Dee-24r/sprint/image.png

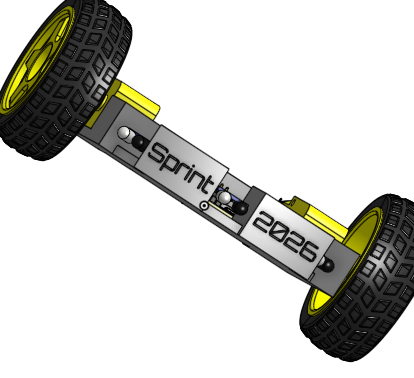
image.png
