Dee-24r/sprint/images/SCH_Sprint-Remote.png

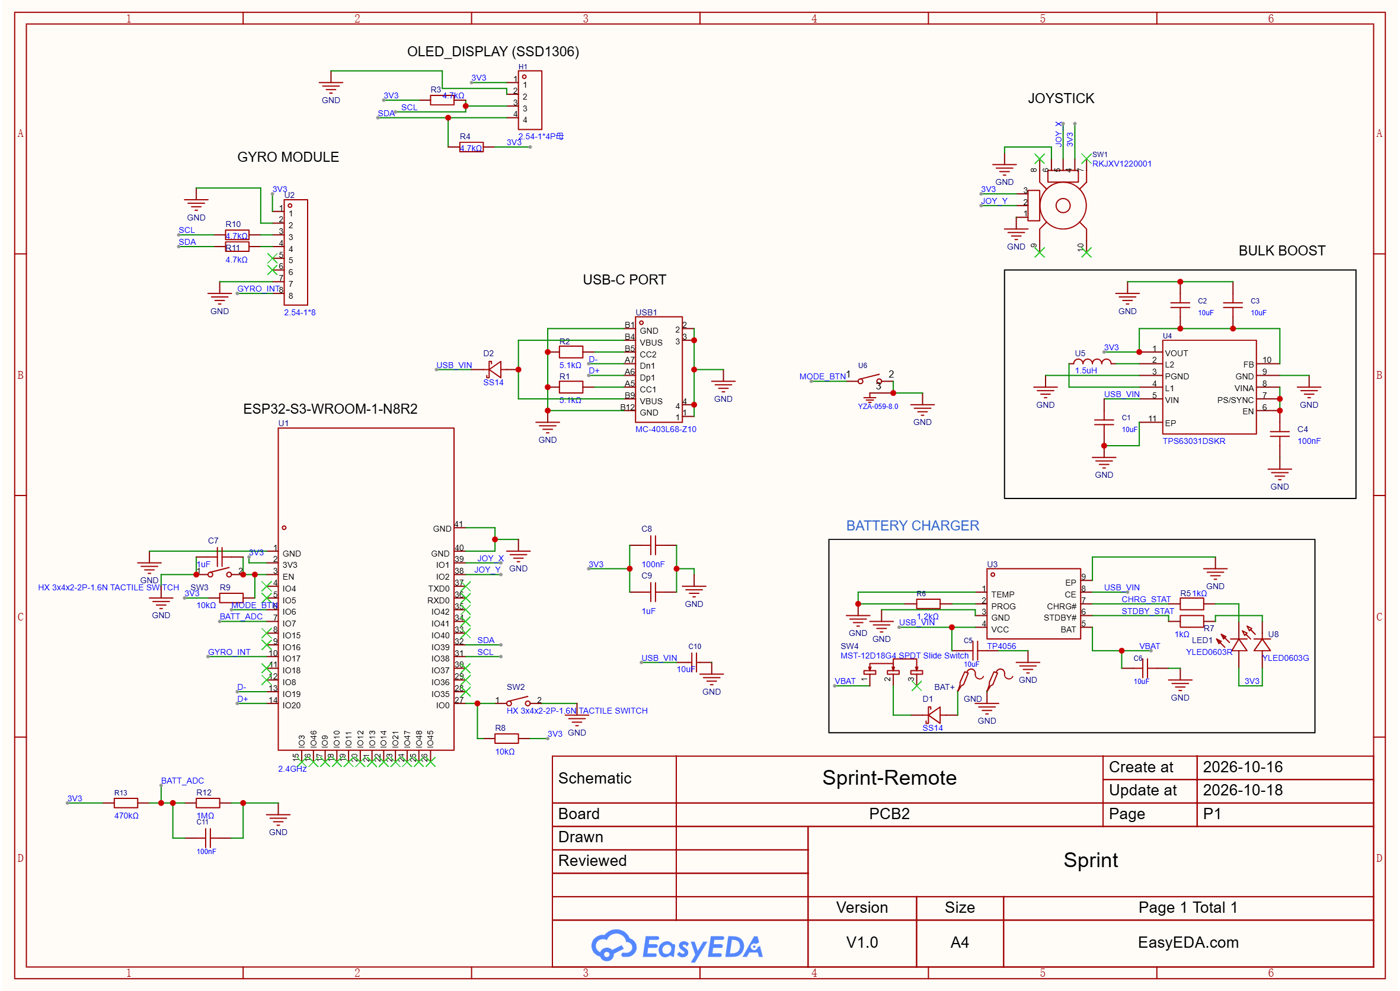
images/SCH_Sprint-Remote.png
