Dee-24r/sprint/images/Sprint-Mainboard.png

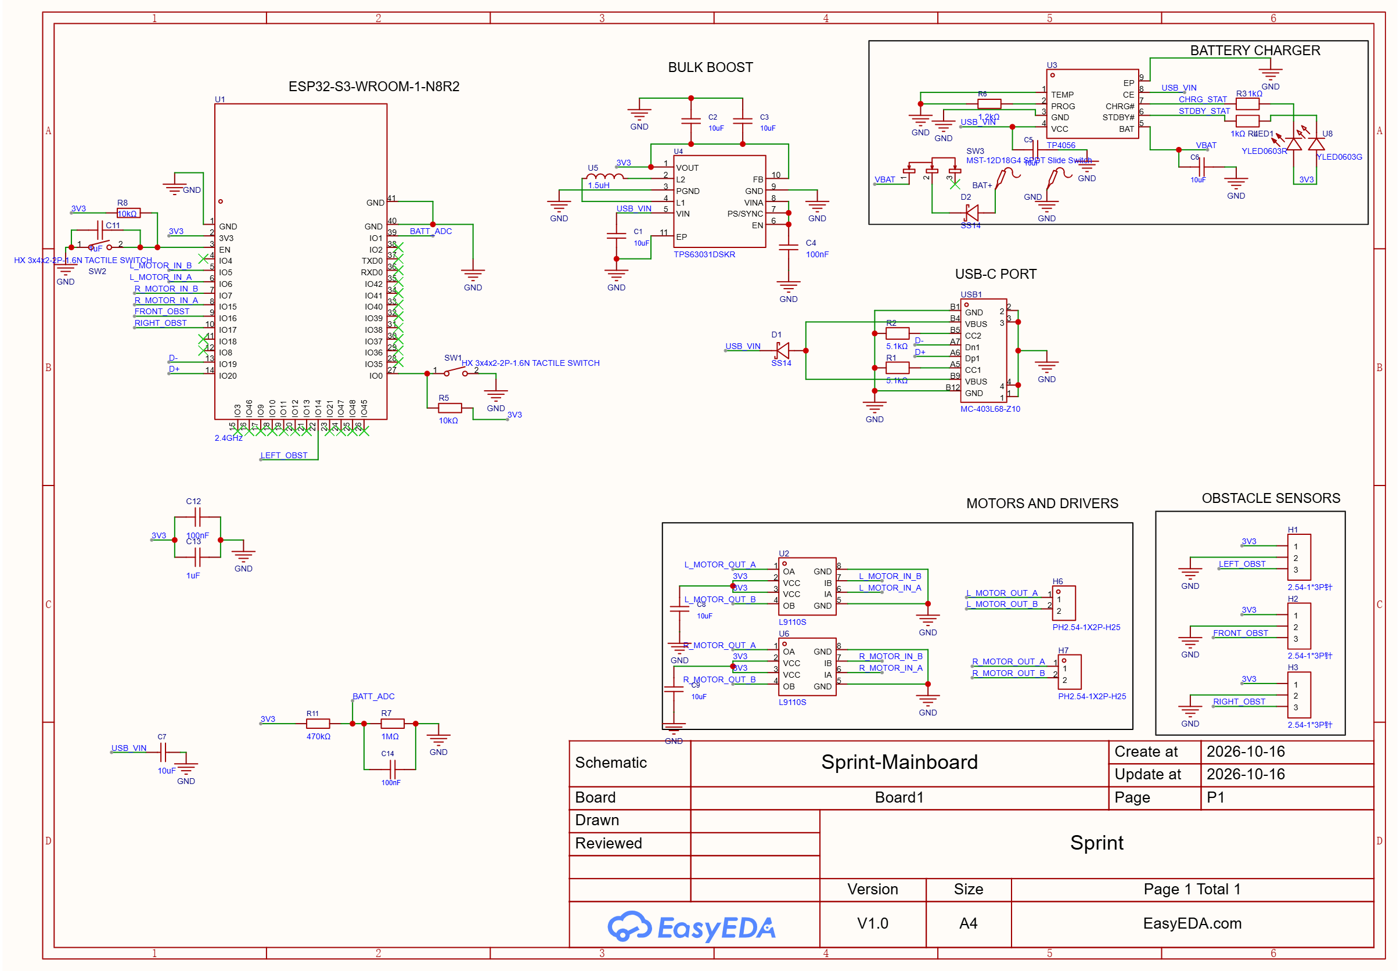
images/Sprint-Mainboard.png
