Dee-24r/sprint/PCB/Remote/BOM_PCB2_PCB-Sprint-Remote.csv

No. | Quantity | Comment | Designator | Footprint | Value | Manufacturer Part | Manufacturer | Supplier Part | Supplier | LCSC Price | JLCPCB Price
1 | 2 | Test-Point | BAT+,GND | Test-Point-0.5mm |  |  |  |  |  | 1.9867
2 | 5 | 10uF | C1,C2,C3,C5,C6 | C0603 | 10uF | TCC0603X7R106M6R3CT | CCTC(三环) | C53032292 | LCSC |  | 0.0052
3 | 1 | 100nF | C4 | C0402 | 100nF | CGA0402X7R104K6R3GT | HRE(芯声) | C22435938 | LCSC |  | 0.0005
4 | 2 | 1uF | C7,C9 | C0603 | 1uF | TCC0603X5R105K160CT | CCTC(三环) | C696901 | LCSC |  | 0.0011
5 | 1 | 100nF | C8 | C0402 | 100nF | CL05B104KO5NNNC | SAMSUNG(三星) | C1525 | LCSC |  | 0.0008
6 | 1 | 10uF | C10 | C0603 | 10uF | CC0603MRX5R7BB106 | YAGEO(国巨) | C109457 | LCSC |  | 0.0422
7 | 1 | 100nF | C11 | C0603 | 100nF | CC0603KRX7R9BB104 | YAGEO(国巨) | C14663 | LCSC |  | 0.0017
8 | 2 | SS14 | D1,D2 | SMA_L4.3-W2.6-LS5.0-RD |  | SS14 | YONGYUTAI(永裕泰) | C47147601 | LCSC |  | 0.0017
9 | 1 | 2.54-1*4P母 | H1 | HDR-TH_4P-P2.54-V-F |  | 2.54-1*4P母 | BOOMELE(博穆精密) | C2718488 | LCSC |  | 0.0124
10 | 1 | YLED0603R | LED1 | LED0603-FD |  | YLED0603R | YONGYUTAI(永裕泰) | C19171390 | LCSC |  | 0.001
11 | 2 | 5.1kΩ | R1,R2 | R0402 | 5.1kΩ | FRC0402J512 TS | FOJAN(富捷) | C2906948 | LCSC |  | 0.0003
12 | 4 | 4.7kΩ | R3,R4,R10,R11 | R0603 | 4.7kΩ | 0603WAF4701T5E | UNI-ROYAL(厚声) | C23162 | LCSC |  | 0.0005
13 | 2 | 1kΩ | R5,R7 | R0402 | 1kΩ | FRC0402J102 TS | FOJAN(富捷) | C2906899 | LCSC |  | 0.0002
14 | 1 | 1.2kΩ | R6 | R0603 | 1.2kΩ | 0603WAF1201T5E | UNI-ROYAL(厚声) | C22765 | LCSC |  | 0.0006
15 | 2 | 10kΩ | R8,R9 | R0603 | 10kΩ | RC0603FR-0710KL | YAGEO(国巨) | C98220 | LCSC |  | 0.0006
16 | 1 | 1MΩ | R12 | R0603 | 1MΩ | AC0603FR-071ML | YAGEO(国巨) | C116678 | LCSC |  | 0.0009
17 | 1 | 470kΩ | R13 | R0603 | 470kΩ | 0603WAF4703T5E | UNI-ROYAL(厚声) | C23178 | LCSC |  | 0.0005
18 | 1 | RKJXV1220001 | SW1 | SW-TH_RKJXV1220001 |  | RKJXV1220001 | ALPSALPINE(阿尔卑斯阿尔派) | C219778 | LCSC |  | 0.1142
19 | 2 | HX 3x4x2-2P-1.6N TACTILE SWITCH | SW2,SW3 | KEY-SMD_L4.0-W3.0-LS4.9-1 |  | HX 3x4x2-2P-1.6N TACTILE SWITCH | hanxia(韩下) | C49234124 | LCSC |  | 0.0038
20 | 1 | MST-12D18G4 SPDT Slide Switch | SW4 | SW-SMD_MST-12D18G4-SPDT-SLIDE-SWITCH |  | MST-12D18G4 SPDT Slide Switch | SHOU HAN(首韩) | C49023767 | LCSC |  | 0.0126
21 | 1 | 2.4GHz | U1 | WIRELM-SMD_ESP32-S3-WROOM-1 | 2.4GHz | ESP32-S3-WROOM-1-N8R2 | ESPRESSIF(乐鑫) | C2913204 | LCSC |  | 0.6996
22 | 1 | 2.54-1*8 | U2 | HDR-TH_8P-P2.54-V-M |  | 2.54-1*8 | ZHOURI(洲日) | C5156616 | LCSC |  | 0.0067
23 | 1 | TP4056 | U3 | ESOP-8_L4.9-W3.9-P1.27-LS6.0-BL-EP |  | TP4056 | UMW(友台半导体) | C725790 | LCSC |  | 0.014
24 | 1 | TPS63031DSKR | U4 | SON-10_L2.5-W2.5-P0.50-TL-EP |  | TPS63031DSKR | TI(德州仪器) | C15516 | LCSC |  | 0.1555
25 | 1 | 1.5uH | U5 | IND-SMD_L3.0-W3.0_LPS3015-222ML | 1.5uH | LPS3015-152MRC | Coilcraft(线艺) | C17382749 | LCSC |  | 0.1731
26 | 1 | YZA-059-8.0 | U6 | SW-TH_YZA-059-8.0 |  | YZA-059-8.0 | YIZHI(逸致) | C49108696 | LCSC
27 | 1 | YLED0603G | U8 | LED0603-FD |  | YLED0603G | YONGYUTAI(永裕泰) | C19273151 | LCSC |  | 0.001
28 | 1 | MC-403L68-Z10 | USB1 | USB-TYPE-C-SMD_MC-403L68-Z10 |  | MC-403L68-Z10 | HANBO(汉博) | C47326496 | LCSC |  | 0.0089
