Dee-24r/sprint/CAD/Mainboard/Sprint-Mainboard-Enclosure.step

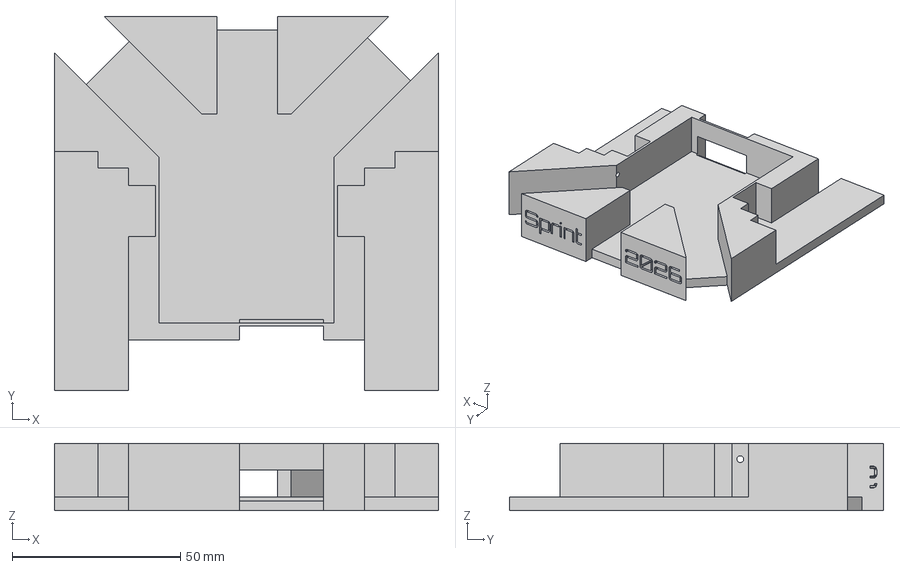
[picture p6: CAD file, 2026-10-19]
CAD/Mainboard/Sprint-Mainboard-Enclosure.step
114.0 x 111.0 x 20.0 mm
