Dee-24r/sprint/CAD/Remote/Sprint-Remote-Assembly.step

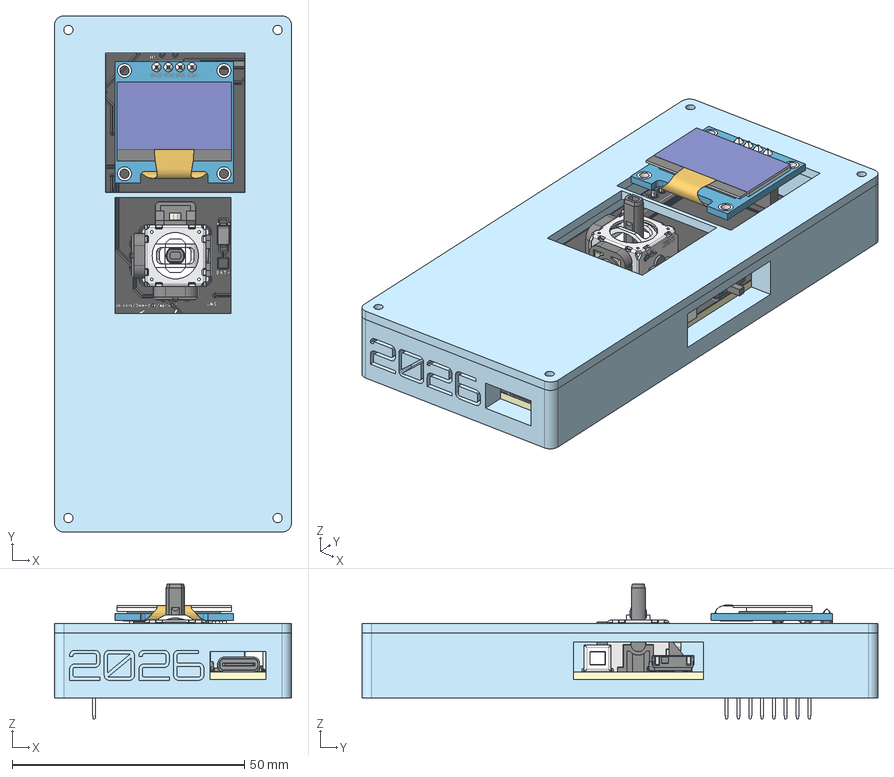
[picture p7: CAD file, 2026-10-19]
CAD/Remote/Sprint-Remote-Assembly.step
51.0 x 111.0 x 29.0 mm
smd_capacitor (6) x 3
smd_capacitor (4) x 3
smd_capacitor (2) x 3
smd_capacitor (1) x 3
smd_capacitor (3) x 3
pin_header x 8
smd_capacitor (7) x 3
472_smd_resistor_2 x 3
soldering x 4
board x 9
472_smd_resistor x 3
472_smd_resistor (1) x 3
914_smd_resistor x 3
smd_capacitor x 3
flat_cable
smd_capacitor (5) x 3
screen x 3
SOT-23_XC6206 v3 x 4
472_smd_resistor_1 x 3
t4_smd_diode x 3
SMA_L4.3-W2.6-LS5.0-RD~SMA_L4.3-W2.6-LS5.0-RD~I4bK__Í¹Ì¨ -ï¿½ï¿½ï¿½ï¿½3 x 2
C0402~C0402_L1.0-W0.5-H0.5~Y2Hd__Í¹Ì¨-ï¿½ ï¿½ï¿½ï¿½3 x 2
C0603~C0603_L1.6-W0.8-H0.8~sAno__Í¹Ì¨-ï¿½ ï¿½ï¿½ï¿½3 x 9
KEY-SMD_L4.0-W3.0-LS4.9-1~KEY-SMD_L4.0-W3.0-LS4.9-1~9hyR__Í¹Ì ¨-ï¿½ï¿½ï¿½ï¿½8 x 2
Board~YImb
R0402~R0402_L1.0-W0.5-H0.4~VQH2__Í¹Ì¨-ï¿½ ï¿½ï¿½ï¿½5 x 4
R0402~R0402_L1.0-W0.5-H0.4~VQH2__ï¿½ï¿½ï¿ ½ï¿½1 x 8
R0603~R0603~k6R3__ï¿½ï¿½ï ¿½ï¿½2 x 9
R0603~R0603~k6R3__ï¿½Ð³ï¿½-ï¿ ½ï¿½ï¿½ï¿½2 x 9
R0603~R0603~k6R3__Í¹Ì¨-ï¿½ ï¿½ï¿½ï¿½3 x 9
R0603~R0603~k6R3__Í¹Ì¨-ï¿½ ï¿½ï¿½ï¿½2 x 9
SW-SMD_MST-12D18G4-SPDT-SLIDE-SWITCH~SW-SMD_MST-12D18G4-SPDT-SLIDE-SW ITCH~dbNO__Ô²ï¿½ï¿½1
SW-SMD_MST-12D18G4-SPDT-SLIDE-SWITCH~SW-SMD_MST-12D18G4-SPDT-SLIDE-SW ITCH~dbNO__Êµï¿½ï¿½-ï¿½Æ ¶ï¿½/ï¿½ï¿½ï¿½ï ¿½1[2]
BottomSilkscreen~YImb x 3
USB-TYPE-C-SMD_MC-403L68-Z10~USB-TYPE-C-SMD_MC-403L68-Z10~tTjW__Í ¹Ì¨-ï¿½ï¿½ï¿½ï¿ ½10
USB-TYPE-C-SMD_MC-403L68-Z10~USB-TYPE-C-SMD_MC-403L68-Z10~tTjW__Ê µï¿½ï¿½-ï¿½Æ¶ï¿ ½/ï¿½ï¿½ï¿½ï¿½1[2]
SON-10_L2.5-W2.5-P0.50-TL-EP~SON-10_L2.5-W2.5-H0.8-P0.50~X88p__Í¹ Ì¨-ï¿½ï¿½ï¿½ï¿½ 4[10]
SON-10_L2.5-W2.5-P0.50-TL-EP~SON-10_L2.5-W2.5-H0.8-P0.50~X88p__Í¹ Ì¨-ï¿½ï¿½ï¿½ï¿½ 4[5]
SON-10_L2.5-W2.5-P0.50-TL-EP~SON-10_L2.5-W2.5-H0.8-P0.50~X88p__Í¹ Ì¨-ï¿½ï¿½ï¿½ï¿½ 4[3]
SON-10_L2.5-W2.5-P0.50-TL-EP~SON-10_L2.5-W2.5-H0.8-P0.50~X88p__Í¹ Ì¨-ï¿½ï¿½ï¿½ï¿½ 4[13]
SON-10_L2.5-W2.5-P0.50-TL-EP~SON-10_L2.5-W2.5-H0.8-P0.50~X88p__Í¹ Ì¨-ï¿½ï¿½ï¿½ï¿½ 4[4]
SON-10_L2.5-W2.5-P0.50-TL-EP~SON-10_L2.5-W2.5-H0.8-P0.50~X88p__Í¹ Ì¨-ï¿½ï¿½ï¿½ï¿½ 4[9]
SON-10_L2.5-W2.5-P0.50-TL-EP~SON-10_L2.5-W2.5-H0.8-P0.50~X88p__Í¹ Ì¨-ï¿½ï¿½ï¿½ï¿½ 4[11]
SON-10_L2.5-W2.5-P0.50-TL-EP~SON-10_L2.5-W2.5-H0.8-P0.50~X88p__Í¹ Ì¨-ï¿½ï¿½ï¿½ï¿½ 4[2]
SON-10_L2.5-W2.5-P0.50-TL-EP~SON-10_L2.5-W2.5-H0.8-P0.50~X88p__Í¹ Ì¨-ï¿½ï¿½ï¿½ï¿½ 4[7]
SON-10_L2.5-W2.5-P0.50-TL-EP~SON-10_L2.5-W2.5-H0.8-P0.50~X88p__Í¹ Ì¨-ï¿½ï¿½ï¿½ï¿½ 4[8]
SON-10_L2.5-W2.5-P0.50-TL-EP~SON-10_L2.5-W2.5-H0.8-P0.50~X88p__Í¹ Ì¨-ï¿½ï¿½ï¿½ï¿½ 4[1]
SON-10_L2.5-W2.5-P0.50-TL-EP~SON-10_L2.5-W2.5-H0.8-P0.50~X88p__ï¿ ½ï¿½ï¿½ï¿½1
SON-10_L2.5-W2.5-P0.50-TL-EP~SON-10_L2.5-W2.5-H0.8-P0.50~X88p__Í¹ Ì¨-ï¿½ï¿½ï¿½ï¿½ 4[6]
SON-10_L2.5-W2.5-P0.50-TL-EP~SON-10_L2.5-W2.5-H0.8-P0.50~X88p__Í¹ Ì¨-ï¿½ï¿½ï¿½ï¿½ 4[12]
IND-SMD_L3.0-W3.0_LPS3015-222ML~IND-SMD_L3.0-W3.0_LPS3015-222ML~dwUU_ _ï¿½ï¿½ï¿½ï¿½1
IND-SMD_L3.0-W3.0_LPS3015-222ML~IND-SMD_L3.0-W3.0_LPS3015-222ML~dwUU_ _Í¹Ì¨-ï¿½ï¿½ï¿½ï ¿½3
IND-SMD_L3.0-W3.0_LPS3015-222ML~IND-SMD_L3.0-W3.0_LPS3015-222ML~dwUU_ _Í¹Ì¨-ï¿½ï¿½ï¿½ï ¿½4
LED0603-FD~LED0603_Inf~gv6h__Í¹Ì¨-ï¿½ï ¿½ï¿½ï¿½2 x 2
LED0603-FD~LED0603_Inf~gv6h__Í¹Ì¨-ï¿½ï ¿½ï¿½ï¿½7 x 2
LED0603-FD~LED0603_Inf~gv6h__ï¿½ï¿½ï¿ ½ï¿½4 x 2
LED0603-FD~LED0603_Inf~gv6h__ï¿½Ð³ï¿½ -ï¿½ï¿½ï¿½ï¿½1 x 2
SW-TH_RKJXV1220001~SW-TH_RKJXV1220001~RN1r__Í¹Ì¨-ï ¿½ï¿½ï¿½ï¿½1[5]
SW-TH_RKJXV1220001~SW-TH_RKJXV1220001~RN1r__SW-TH_THB001P.stp-1/PRT00 02.stp-1-solid2
SW-TH_RKJXV1220001~SW-TH_RKJXV1220001~RN1r__Í¹Ì¨-ï ¿½ï¿½ï¿½ï¿½1[6]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
