Dee-24r/sprint/CAD/Mainboard/Sprint-Mainboard-Assembled.step

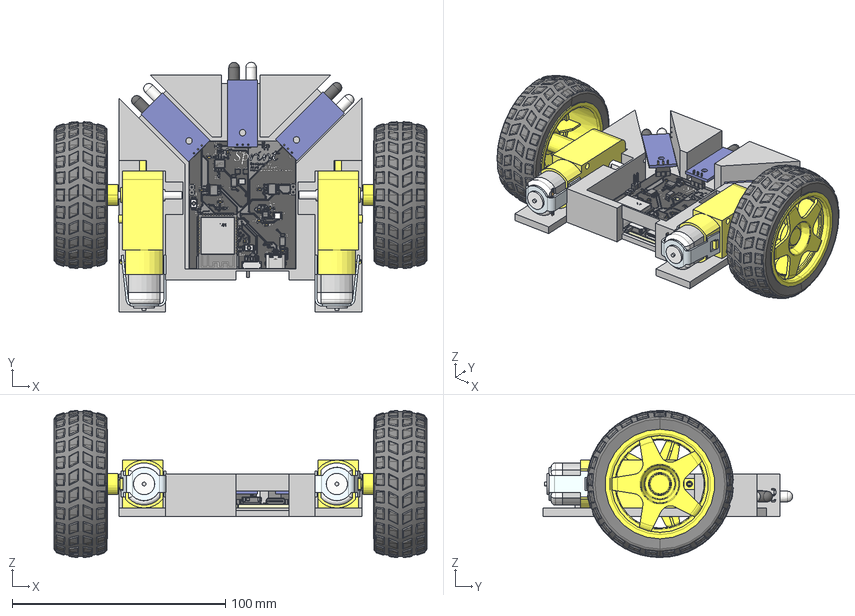
[picture p8: CAD file, 2026-10-19]
CAD/Mainboard/Sprint-Mainboard-Assembled.step
174.8 x 117.0 x 68.9 mm
Komponente1 x 51
Part 5:1__Corps1 x 2
Part 1:1__Corps1 x 2
Part 6:1__Corps1 x 2
Surface 1:1__Corps1
Part 8:1__Corps1 x 2
Rim x 2
Part 3:1__Corps1 x 2
Part 7:1__Corps1 x 2
Part 2:1__Corps1 x 2
Part 4:1__Corps1 x 2
Tyre x 2
C0603~C0603_L1.6-W0.8-H0.8~e9zY__Í¹Ì¨-ï¿½ ï¿½ï¿½ï¿½3 x 11
KEY-SMD_L4.0-W3.0-LS4.9-1~KEY-SMD_L4.0-W3.0-LS4.9-1~WPdS__Í¹Ì ¨-ï¿½ï¿½ï¿½ï¿½8 x 2
C0402~C0402_L1.0-W0.5-H0.5~zgoZ__Í¹Ì¨-ï¿½ ï¿½ï¿½ï¿½3 x 2
SMA_L4.3-W2.6-LS5.0-RD~SMA_L4.3-W2.6-LS5.0-RD~SOsg__Í¹Ì¨ -ï¿½ï¿½ï¿½ï¿½3 x 2
HDR-TH_2P-P2.54-V-M-4~HDR-TH_2P-P2.54-V-M-4~FHF3__Í¹Ì¨ -ï¿½ï¿½ï¿½ï¿½3 x 2
HDR-TH_3P-P2.54-V-M-1~HDR-M-2.54_1x3~xn9p__ï¿½ï¿½ ï¿½ï¿½(ï¿½ï¿½ï¿ ½ï¿½)1[1] x 3
HDR-TH_3P-P2.54-V-M-1~HDR-M-2.54_1x3~xn9p__ï¿½ï¿½ ï¿½ï¿½(ï¿½ï¿½ï¿ ½ï¿½)1[2] x 3
HDR-TH_3P-P2.54-V-M-1~HDR-M-2.54_1x3~xn9p__Í¹Ì¨-ï ¿½ï¿½ï¿½ï¿½4 x 3
R0603~R0603~eucx__ï¿½Ð³ï¿½-ï¿ ½ï¿½ï¿½ï¿½2 x 5
R0603~R0603~eucx__Í¹Ì¨-ï¿½ ï¿½ï¿½ï¿½3 x 5
R0603~R0603~eucx__ï¿½ï¿½ï ¿½ï¿½2 x 5
R0603~R0603~eucx__Í¹Ì¨-ï¿½ ï¿½ï¿½ï¿½2 x 5
R0402~R0402_L1.0-W0.5-H0.4~To47__ï¿½ï¿½ï¿ ½ï¿½1 x 8
R0402~R0402_L1.0-W0.5-H0.4~To47__Í¹Ì¨-ï¿½ ï¿½ï¿½ï¿½5 x 4
SW-SMD_MST-12D18G4-SPDT-SLIDE-SWITCH~SW-SMD_MST-12D18G4-SPDT-SLIDE-SW ITCH~YffU__Êµï¿½ï¿½-ï¿½Æ ¶ï¿½/ï¿½ï¿½ï¿½ï ¿½1[2]
SW-SMD_MST-12D18G4-SPDT-SLIDE-SWITCH~SW-SMD_MST-12D18G4-SPDT-SLIDE-SW ITCH~YffU__Ô²ï¿½ï¿½1
Board~zdil
LED0603-FD~LED0603_Inf~lXOp__Í¹Ì¨-ï¿½ï ¿½ï¿½ï¿½2 x 2
LED0603-FD~LED0603_Inf~lXOp__ï¿½Ð³ï¿½ -ï¿½ï¿½ï¿½ï¿½1 x 2
LED0603-FD~LED0603_Inf~lXOp__Í¹Ì¨-ï¿½ï ¿½ï¿½ï¿½7 x 2
LED0603-FD~LED0603_Inf~lXOp__ï¿½ï¿½ï¿ ½ï¿½4 x 2
USB-TYPE-C-SMD_MC-403L68-Z10~USB-TYPE-C-SMD_MC-403L68-Z10~mBQt__Í ¹Ì¨-ï¿½ï¿½ï¿½ï¿ ½10
USB-TYPE-C-SMD_MC-403L68-Z10~USB-TYPE-C-SMD_MC-403L68-Z10~mBQt__Ê µï¿½ï¿½-ï¿½Æ¶ï¿ ½/ï¿½ï¿½ï¿½ï¿½1[2]
IND-SMD_L3.0-W3.0_LPS3015-222ML~IND-SMD_L3.0-W3.0_LPS3015-222ML~G3mU_ _ï¿½ï¿½ï¿½ï¿½1
IND-SMD_L3.0-W3.0_LPS3015-222ML~IND-SMD_L3.0-W3.0_LPS3015-222ML~G3mU_ _Í¹Ì¨-ï¿½ï¿½ï¿½ï ¿½3
IND-SMD_L3.0-W3.0_LPS3015-222ML~IND-SMD_L3.0-W3.0_LPS3015-222ML~G3mU_ _Í¹Ì¨-ï¿½ï¿½ï¿½ï ¿½4
ESOP-8_L4.9-W3.9-P1.27-LS6.0-BL-EP~ESOP-8_L4.9-W3.9-H1.6-LS6.0-P1.27~ fzx2__ï¿½ï¿½0.2-ï¿½ï¿½ 0.4-ï¿½ï¿½1.1-ï¿½ï¿½0. 8ï¿½ï¿½ï¿½ï¿½-2-solid1
ESOP-8_L4.9-W3.9-P1.27-LS6.0-BL-EP~ESOP-8_L4.9-W3.9-H1.6-LS6.0-P1.27~ fzx2__Í¹Ì¨-ï¿½ï¿½ï¿½ ï¿½2[6]
ESOP-8_L4.9-W3.9-P1.27-LS6.0-BL-EP~ESOP-8_L4.9-W3.9-H1.6-LS6.0-P1.27~ fzx2__ï¿½ï¿½0.2-ï¿½ï¿½ 0.4-ï¿½ï¿½1.1-ï¿½ï¿½0. 8ï¿½ï¿½ï¿½ï¿½-8-solid1
ESOP-8_L4.9-W3.9-P1.27-LS6.0-BL-EP~ESOP-8_L4.9-W3.9-H1.6-LS6.0-P1.27~ fzx2__ï¿½ï¿½0.2-ï¿½ï¿½ 0.4-ï¿½ï¿½1.1-ï¿½ï¿½0. 8ï¿½ï¿½ï¿½ï¿½-1-solid1
ESOP-8_L4.9-W3.9-P1.27-LS6.0-BL-EP~ESOP-8_L4.9-W3.9-H1.6-LS6.0-P1.27~ fzx2__Í¹Ì¨-ï¿½ï¿½ï¿½ ï¿½2[2]
ESOP-8_L4.9-W3.9-P1.27-LS6.0-BL-EP~ESOP-8_L4.9-W3.9-H1.6-LS6.0-P1.27~ fzx2__Í¹Ì¨-ï¿½ï¿½ï¿½ ï¿½2[5]
ESOP-8_L4.9-W3.9-P1.27-LS6.0-BL-EP~ESOP-8_L4.9-W3.9-H1.6-LS6.0-P1.27~ fzx2__Í¹Ì¨-ï¿½ï¿½ï¿½ ï¿½2[9]
ESOP-8_L4.9-W3.9-P1.27-LS6.0-BL-EP~ESOP-8_L4.9-W3.9-H1.6-LS6.0-P1.27~ fzx2__ï¿½ï¿½0.2-ï¿½ï¿½ 0.4-ï¿½ï¿½1.1-ï¿½ï¿½0. 8ï¿½ï¿½ï¿½ï¿½-5-solid1
ESOP-8_L4.9-W3.9-P1.27-LS6.0-BL-EP~ESOP-8_L4.9-W3.9-H1.6-LS6.0-P1.27~ fzx2__Í¹Ì¨-ï¿½ï¿½ï¿½ ï¿½2[1]
ESOP-8_L4.9-W3.9-P1.27-LS6.0-BL-EP~ESOP-8_L4.9-W3.9-H1.6-LS6.0-P1.27~ fzx2__Í¹Ì¨-ï¿½ï¿½ï¿½ ï¿½2[13]
ESOP-8_L4.9-W3.9-P1.27-LS6.0-BL-EP~ESOP-8_L4.9-W3.9-H1.6-LS6.0-P1.27~ fzx2__ï¿½ï¿½0.2-ï¿½ï¿½ 0.4-ï¿½ï¿½1.1-ï¿½ï¿½0. 8ï¿½ï¿½ï¿½ï¿½-4-solid1
ESOP-8_L4.9-W3.9-P1.27-LS6.0-BL-EP~ESOP-8_L4.9-W3.9-H1.6-LS6.0-P1.27~ fzx2__ï¿½ï¿½0.2-ï¿½ï¿½ 0.4-ï¿½ï¿½1.1-ï¿½ï¿½0. 8ï¿½ï¿½ï¿½ï¿½-7-solid1
ESOP-8_L4.9-W3.9-P1.27-LS6.0-BL-EP~ESOP-8_L4.9-W3.9-H1.6-LS6.0-P1.27~ fzx2__ï¿½ï¿½0.2-ï¿½ï¿½ 0.4-ï¿½ï¿½1.1-ï¿½ï¿½0. 8ï¿½ï¿½ï¿½ï¿½-3-solid1
ESOP-8_L4.9-W3.9-P1.27-LS6.0-BL-EP~ESOP-8_L4.9-W3.9-H1.6-LS6.0-P1.27~ fzx2__Í¹Ì¨-ï¿½ï¿½ï¿½ ï¿½2[7]
ESOP-8_L4.9-W3.9-P1.27-LS6.0-BL-EP~ESOP-8_L4.9-W3.9-H1.6-LS6.0-P1.27~ fzx2__ESOP-8_L4.9-W3.9-H1.6-LS6.0-P1.27ï¿½ï¿½ï ¿½ï¿½-1-solid1
ESOP-8_L4.9-W3.9-P1.27-LS6.0-BL-EP~ESOP-8_L4.9-W3.9-H1.6-LS6.0-P1.27~ fzx2__Í¹Ì¨-ï¿½ï¿½ï¿½ ï¿½2[4]
ESOP-8_L4.9-W3.9-P1.27-LS6.0-BL-EP~ESOP-8_L4.9-W3.9-H1.6-LS6.0-P1.27~ fzx2__Í¹Ì¨-ï¿½ï¿½ï¿½ ï¿½2[11]
ESOP-8_L4.9-W3.9-P1.27-LS6.0-BL-EP~ESOP-8_L4.9-W3.9-H1.6-LS6.0-P1.27~ fzx2__Í¹Ì¨-ï¿½ï¿½ï¿½ ï¿½2[10]
ESOP-8_L4.9-W3.9-P1.27-LS6.0-BL-EP~ESOP-8_L4.9-W3.9-H1.6-LS6.0-P1.27~ fzx2__Í¹Ì¨-ï¿½ï¿½ï¿½ ï¿½2[12]
ESOP-8_L4.9-W3.9-P1.27-LS6.0-BL-EP~ESOP-8_L4.9-W3.9-H1.6-LS6.0-P1.27~ fzx2__Í¹Ì¨-ï¿½ï¿½ï¿½ ï¿½2[3]
ESOP-8_L4.9-W3.9-P1.27-LS6.0-BL-EP~ESOP-8_L4.9-W3.9-H1.6-LS6.0-P1.27~ fzx2__Í¹Ì¨-ï¿½ï¿½ï¿½ ï¿½2[8]
ESOP-8_L4.9-W3.9-P1.27-LS6.0-BL-EP~ESOP-8_L4.9-W3.9-H1.6-LS6.0-P1.27~ fzx2__ï¿½ï¿½0.2-ï¿½ï¿½ 0.4-ï¿½ï¿½1.1-ï¿½ï¿½0. 8ï¿½ï¿½ï¿½ï¿½-6-solid1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
