Dee-24r/sprint/CAD/Remote/Sprint-Remote-Top.step

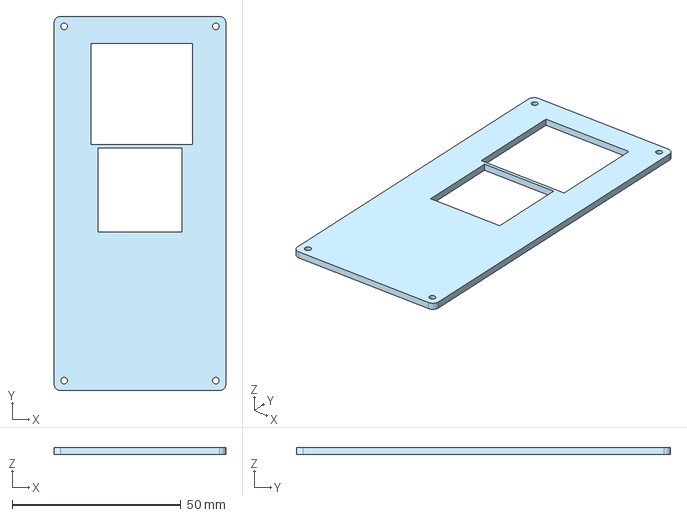
[picture p9: CAD file, 2026-10-19]
CAD/Remote/Sprint-Remote-Top.step
51.0 x 111.0 x 2.00 mm
