Dee-24r/sprint/CAD/Remote/Sprint-Remote-Base.step

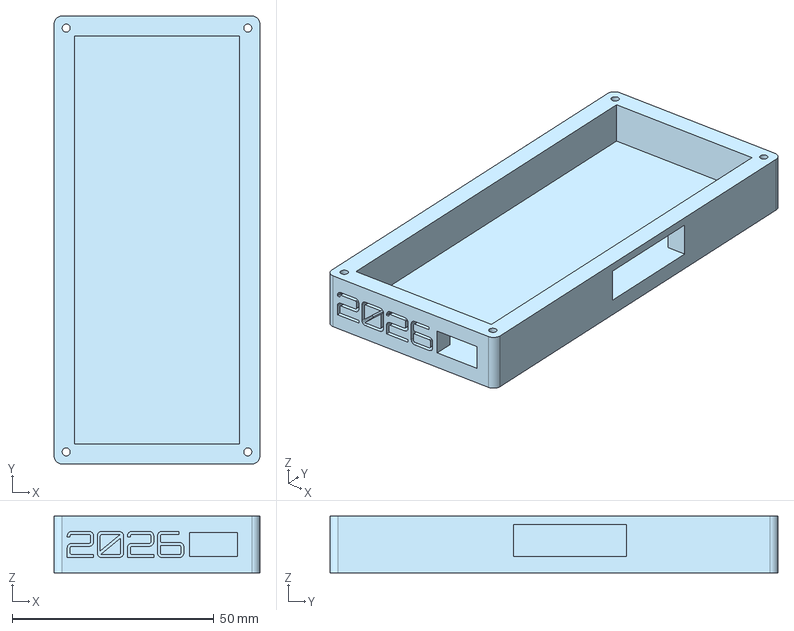
[picture p10: CAD file, 2026-10-19]
CAD/Remote/Sprint-Remote-Base.step
51.0 x 111.0 x 14.0 mm
