Dee-24r/sprint/src/remote/config.h

#pragma once

#define JOY_X 1
#define JOY_Y 2

#define I2C_SDA_PIN 39
#define I2C_SLC_PIN 38

#define BATT_ADC 7
#define GYRO_INT 17 //idk what we're foing w ths

#define MODE_BTN 6

#define SCREEN_WIDTH 128
#define SCREEN_HEIGHT 64
#define OLED_RESET -1
#define SCREEN_ADDRESS 0x3c // i just searched this up, idk how accurate
