Dee-24r/sprint/src/mainboard/config.h

#pragma once

#define CONFIG_H


#define L_MOTOR_A 6
#define L_MOTOR_B 5

#define R_MOTOR_A 15
#define R_MOTOR_B 7

#define FRONT_OBST 16
#define RIGHT_OBST 17
#define LEFT_OBST 14

#define BATT_ADC 1
