Dee-24r/sprint/src/config.h

#pragma once

#define CONFIG_H


#define L_MOTOR_IN_A 6
#define L_MOTOR_IN_B 5

#define R_MOTOR_IN_A 15
#define R_MOTOR_IN_B 7

#define FRONT_OBST 16
#define RIGHT_OBST 17
#define LEFT_OBST 14
