Dee-24r/sprint/(commit log)

2026-10-07 Add project journal entry for RC car schematic
    Documented project initiation and initial schematic decisions for the RC car, including component choices and design considerations.
2026-10-08 Add buck-boost converter and USB-C wiring details
    Documented the addition of a buck-boost converter and USB-C wiring for the PCB controller board of the RC car. Included details on research and component selection.
2026-10-09 Update journal with TP4056 wiring progress
    Documented progress on wiring the TP4056 battery charging module and discussed potential additions to the schematic.
2026-10-10 Update journal with TP4056 wiring progress
    Documented progress on wiring the TP4056 and discussed potential additions to the schematic, including a gyroscope.
2026-10-11 funmi.. 8th and 9th october journal!.. will still update
    Documented progress on wiring and schematic development for the RC car project, including the integration of sensors and features for autonomous control.
2026-10-11 Update journal with mainboard schematic progress
    Documented the completion of the mainboard schematic and details about the wiring and components used.
2026-10-11 Update journal with new images and project details
    Added new images and updated the project description with details about the mainboard schematic and remote control design.
2026-10-13 Update journal entry for PCB completion
    Revised the entry for 10/12/2026 to improve clarity and detail.
2026-10-13 funmi 12th october journlas
    Updated journal entries to reflect project progress and changes in schematic and PCB design.
2026-10-14 Update journal with PCB component placement details
    Documented progress on PCB design and component placement for remote control, including details on component choices and future steps.
2026-10-15 Revise journal entry for 10/14/2026
    Updated journal entry for 10/14/2026 with progress on PCBs and CAD.
2026-10-17 13th and 15th journals.. gonna add pics, funmi
    Added details about PCB wiring, battery measurement, and CAD progress.
2026-10-17 pin definitions for both pcbs (config.h)
2026-10-18 making progress on arduino cod enad esp_now.. going to bed.. or not!
2026-10-18 Revise README with enhanced project details
    Updated project description and added details about features, schematics, and PCBs. Included images and a note about AI assistance.
2026-10-19 Update motor type from N20 to TT Motors
2026-10-19 Add merged BOM section to README above AI note
2026-10-19 Update README BOM table with manufacturer, distributor, part numbers, and prices from the existing LCSC BOM exports
2026-10-19 Add per-part total prices and combined BOM total to README table
2026-10-19 Update README to remove BOM pricing notes
    Removed notes about BOM pricing and unit price calculations.
